Taris9047/astropix-telescope-ANL/README.md

# astropix-telescope

KiCad PCB project for a 4-Layer AstroPix Telescope compatible to AstroPix v2/v3
