Taris9047/astropix-telescope-ANL/Preliminary/AstroPix_telescope_Jan21th2023.png

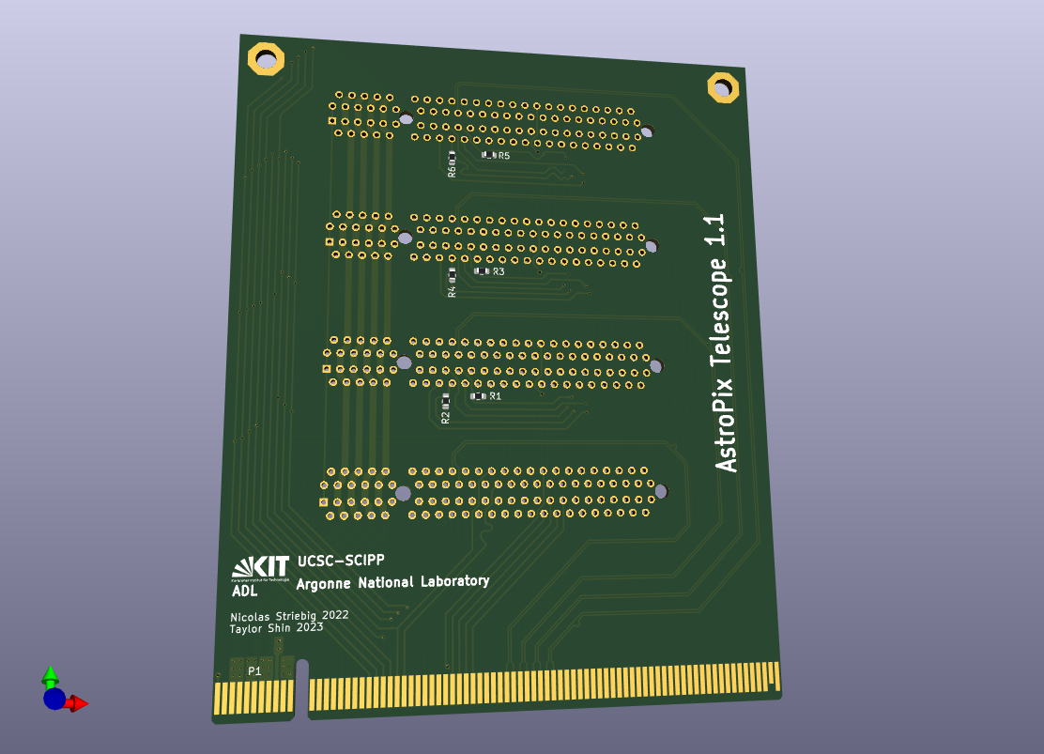
Preliminary/AstroPix_telescope_Jan21th2023.png
