Taris9047/astropix-telescope-ANL/References/ImpedanceMatching.png

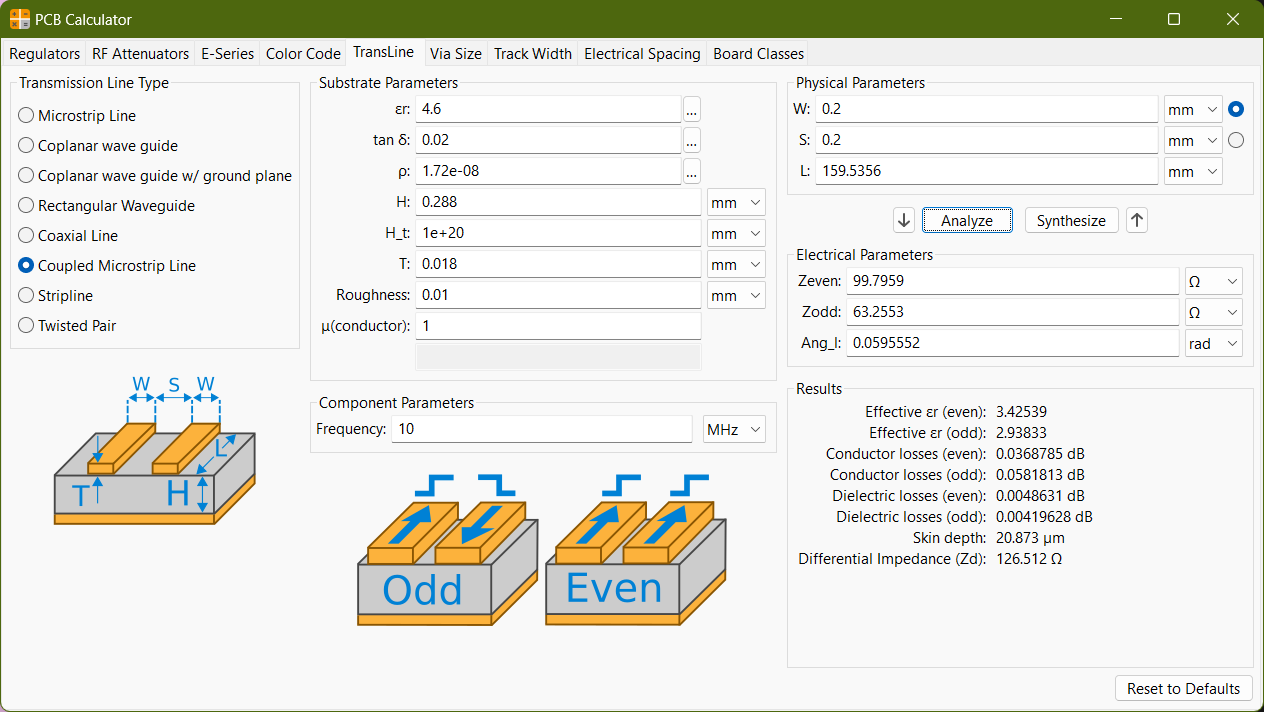
References/ImpedanceMatching.png
