Taris9047/astropix-telescope-ANL/FabricationOutputs/AstroPix_telescope.pdf

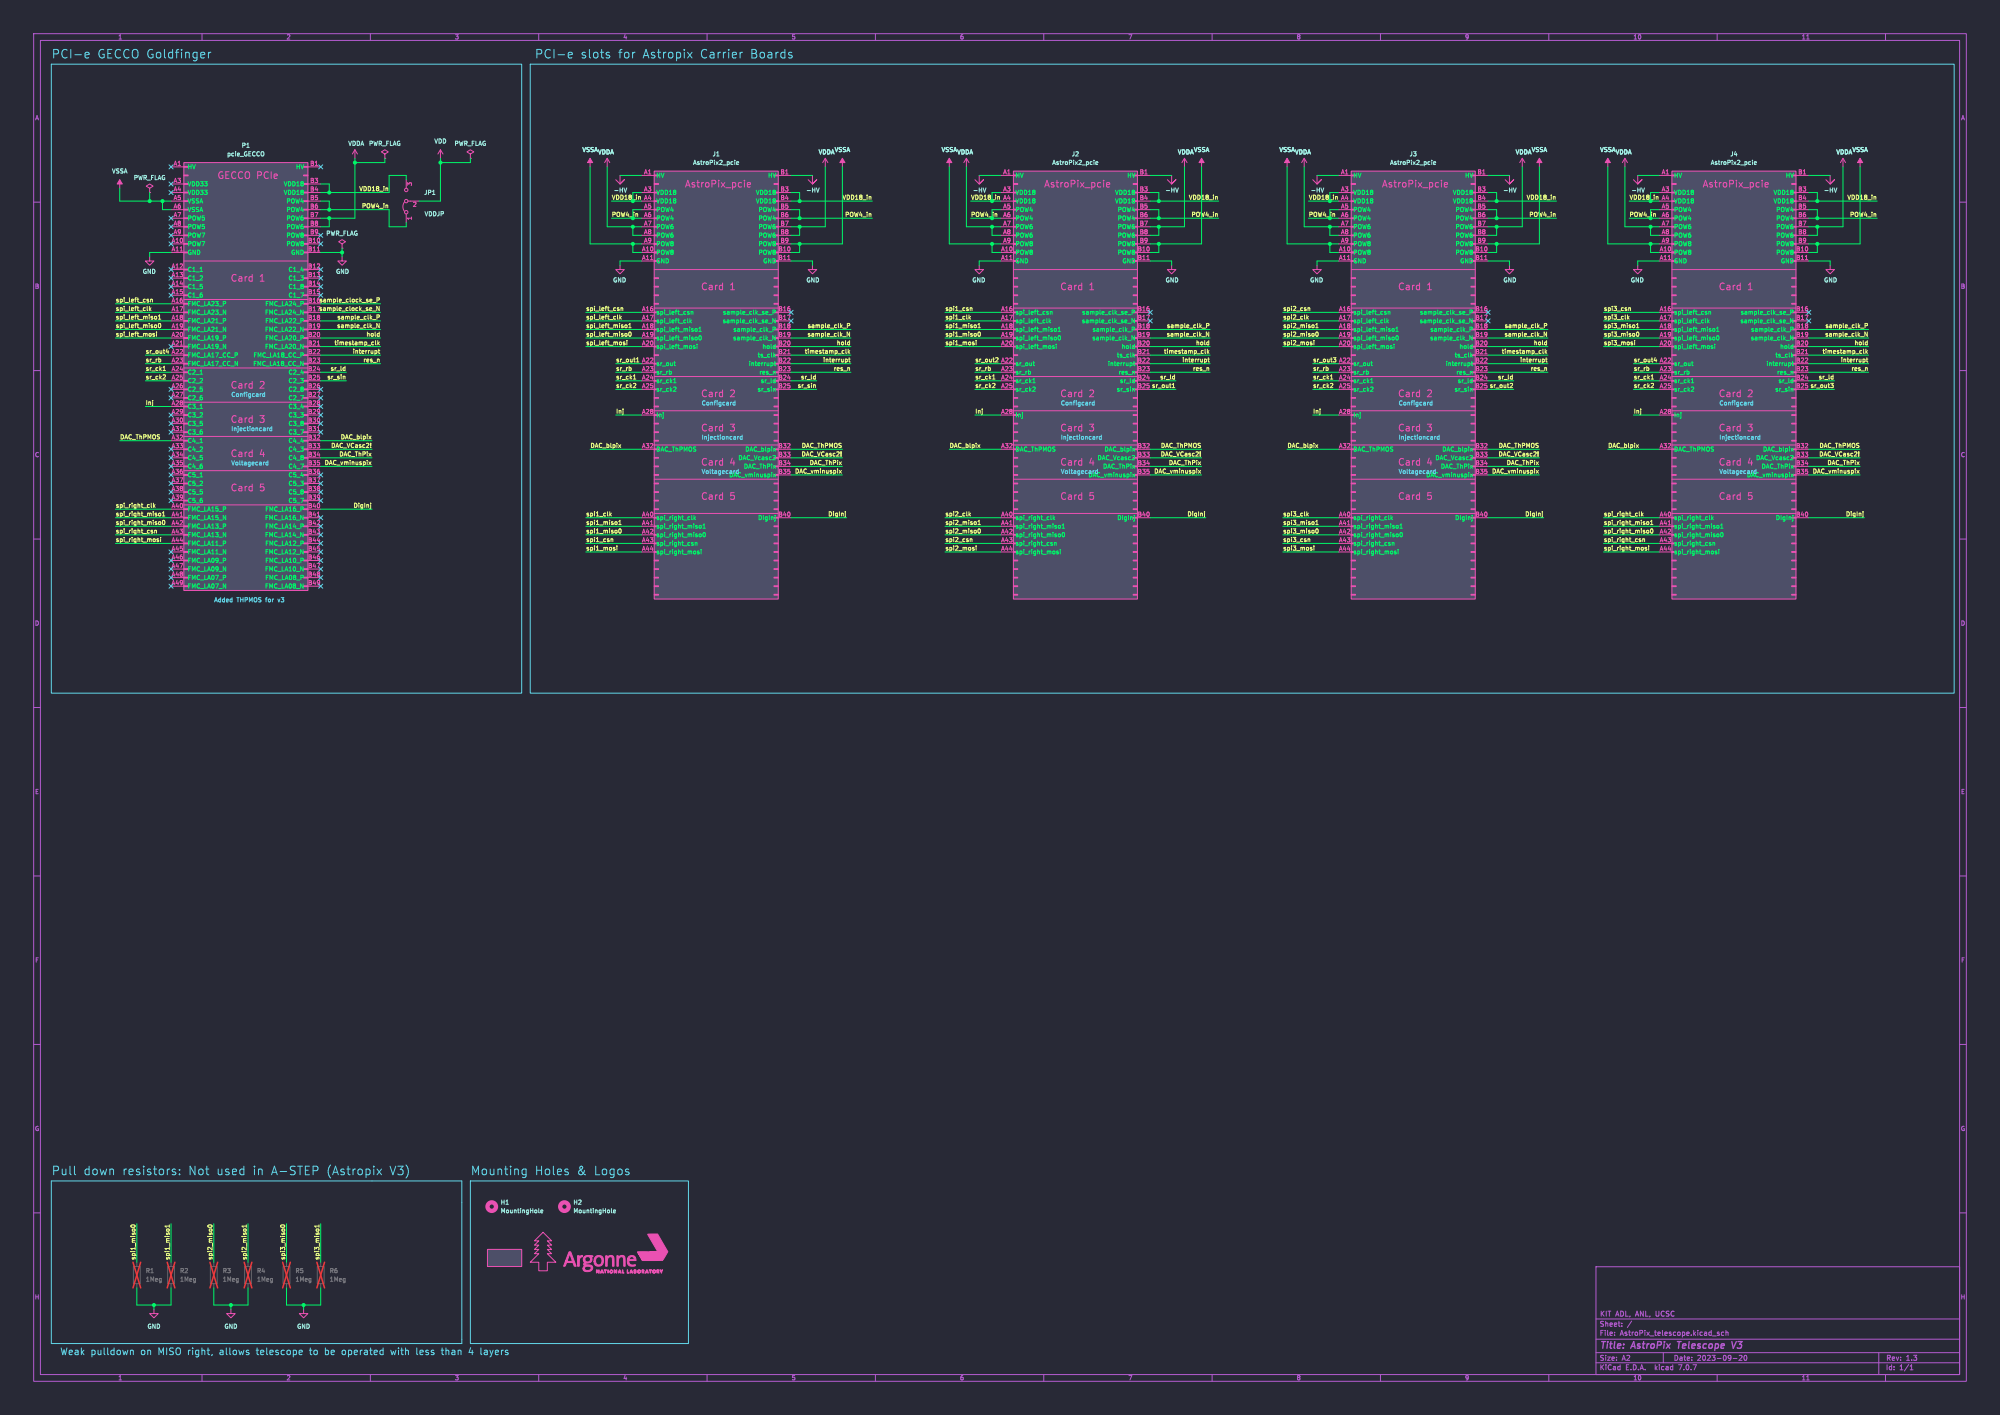
[picture p5: page 1]

PCI-e slots for Astropix Carrier Boards

File: AstroPix_telescope.kicad_sch Sheet: / KIT ADL, ANL, UCSC
