Taris9047/astropix-telescope-ANL/AstroPix_telescope.pdf

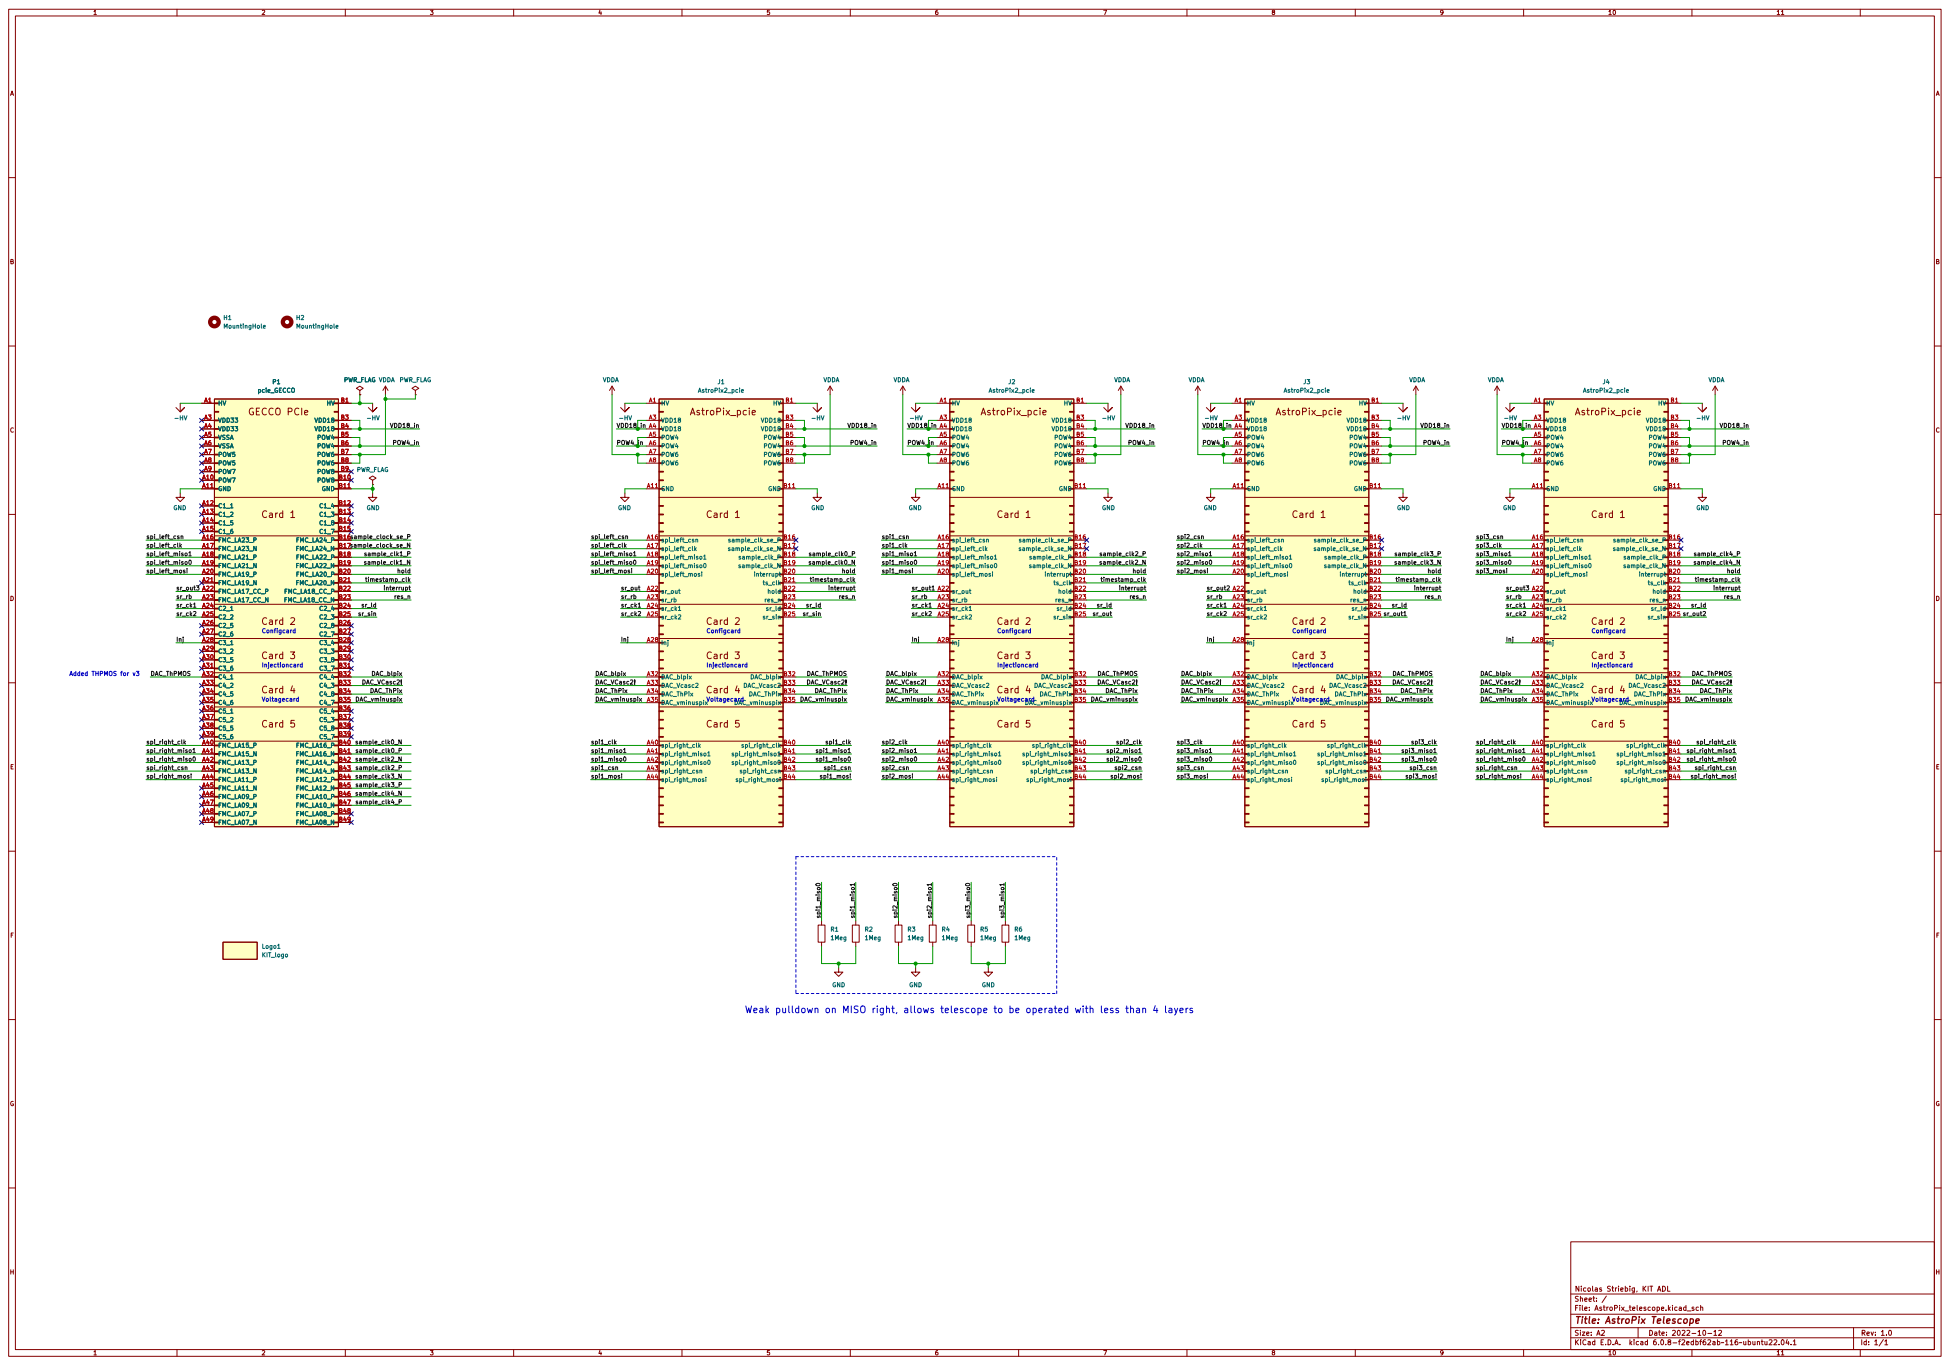
[picture p6: page 1]

Weak pulldown on MISO right, allows telescope to be operated with less than 4 layers

File: AstroPix_telescope.kicad_sch Sheet: / Nicolas Striebig, KIT ADL

Id: 1/1 Title: AstroPix Telescope
