Taris9047/astropix-telescope-ANL/AstroPix_telescope.kicad_pcb

## KiCad design AstroPix_telescope.kicad_pcb (2023-09-20)

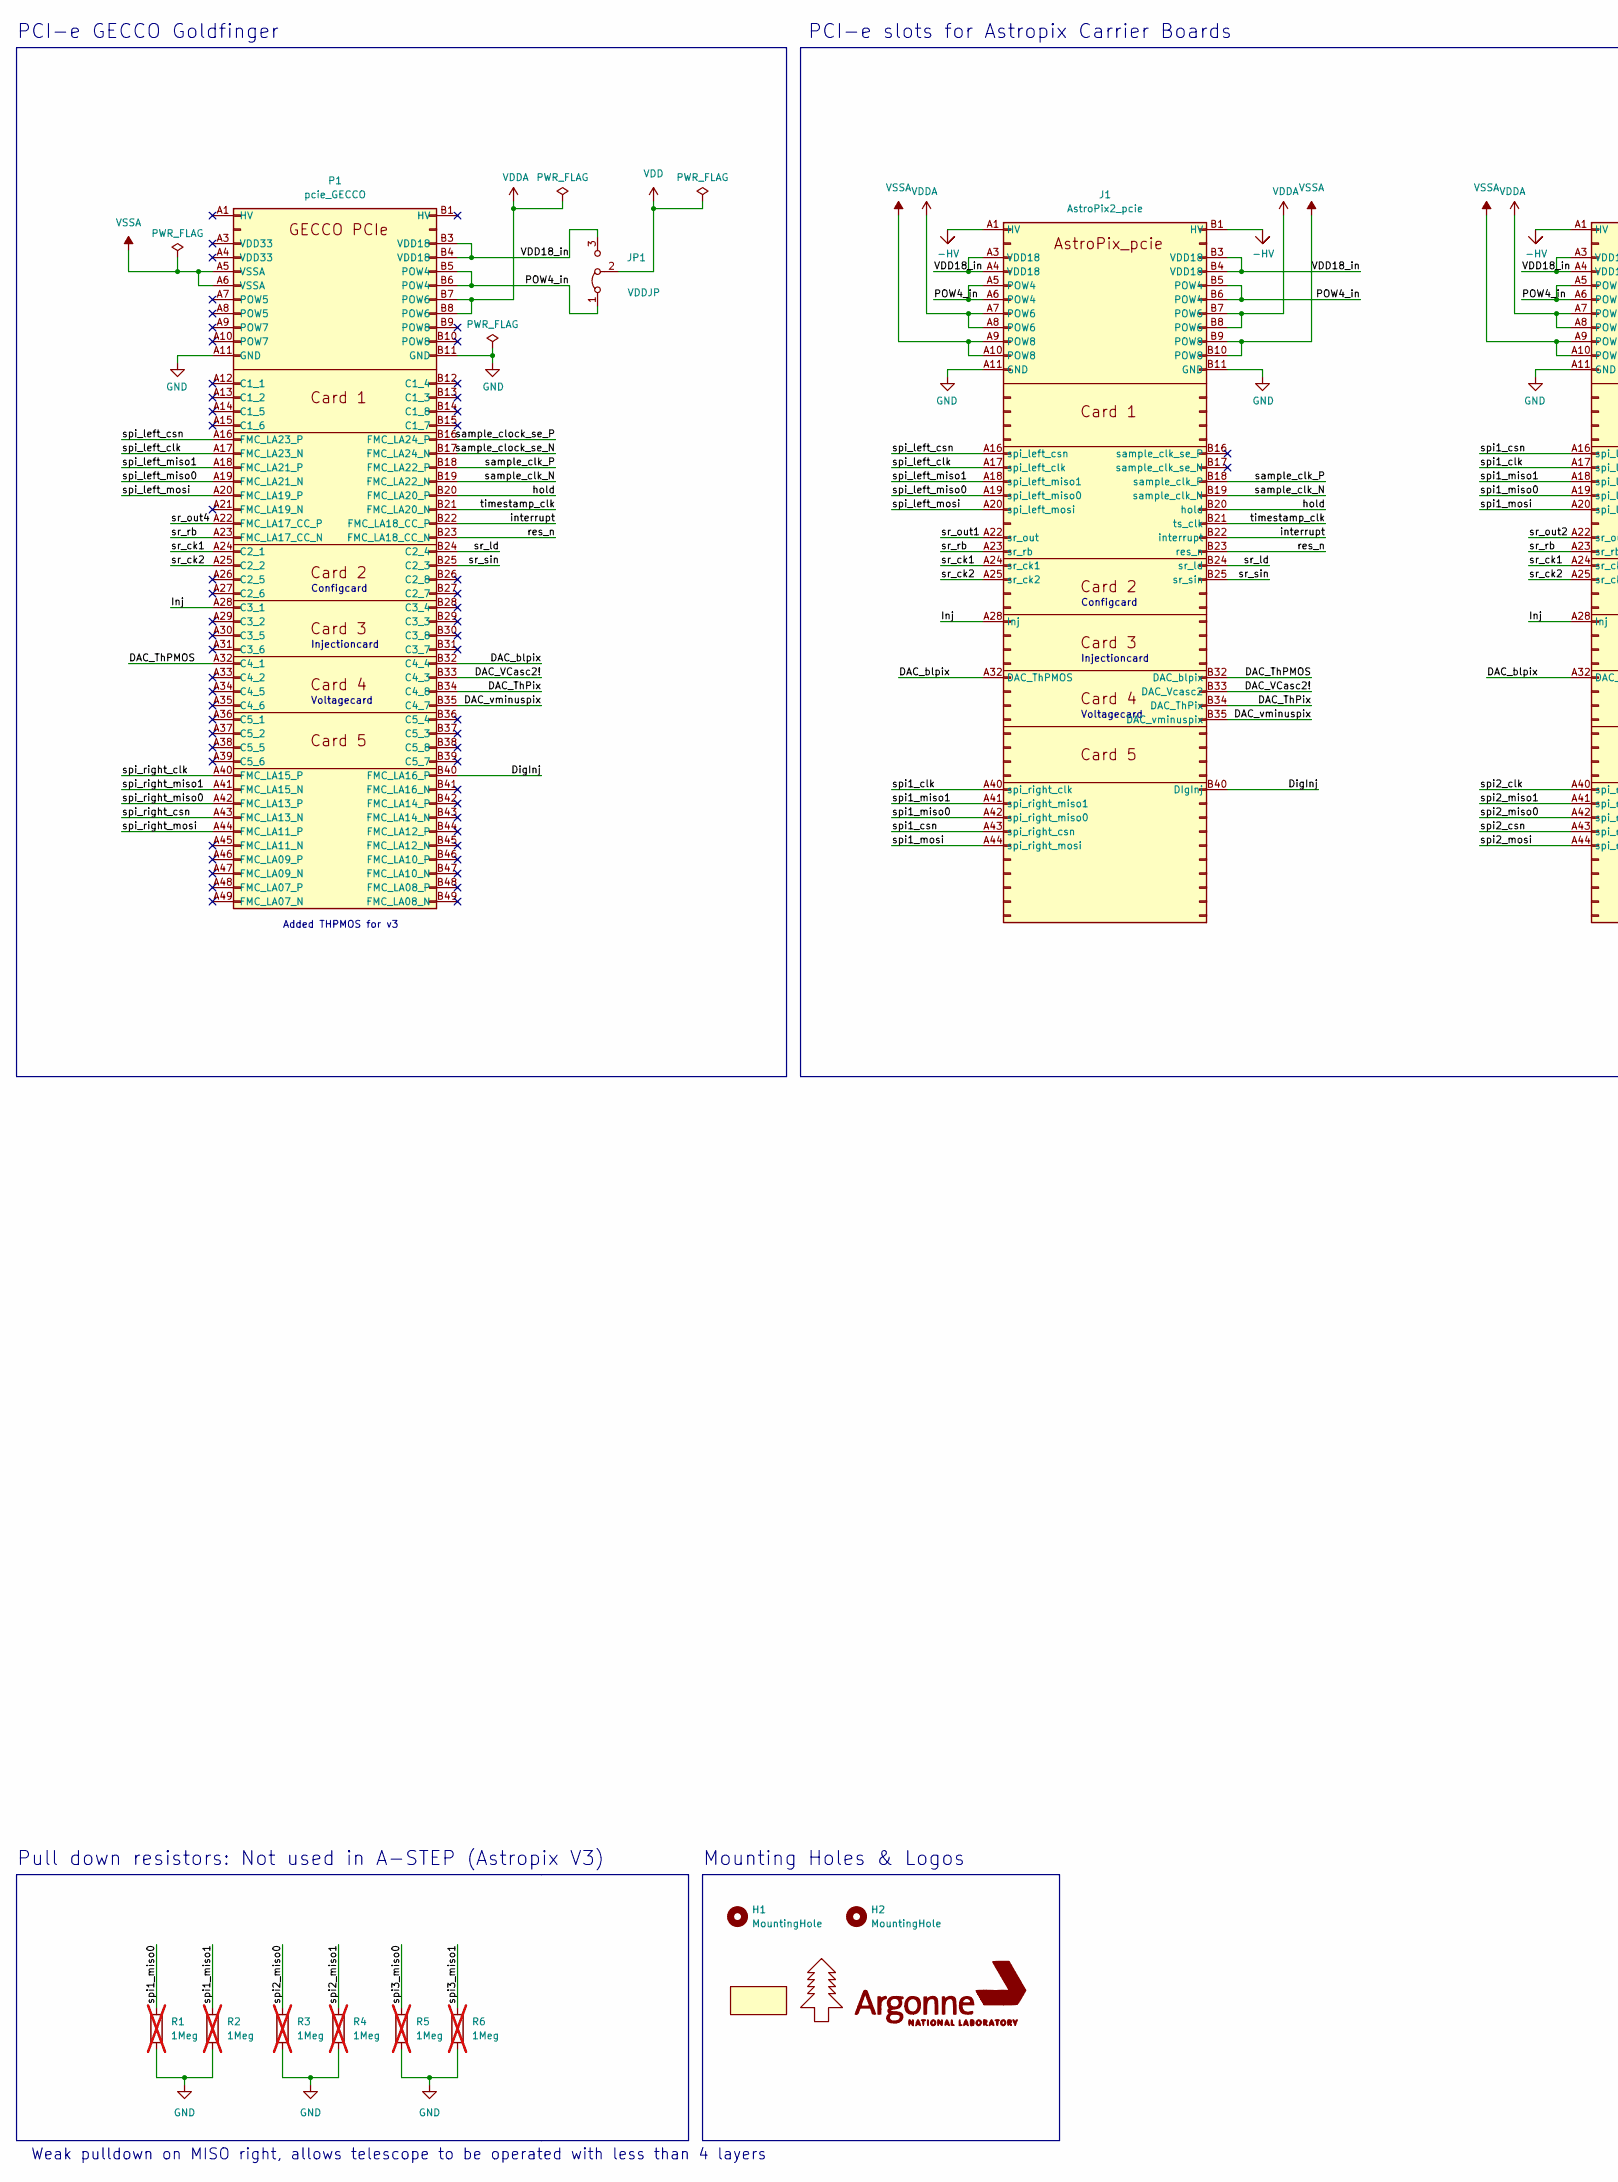
[picture p7: schematic AstroPix_telescope.kicad_sch, AstroPix Telescope V3, part in row 1, column 1]

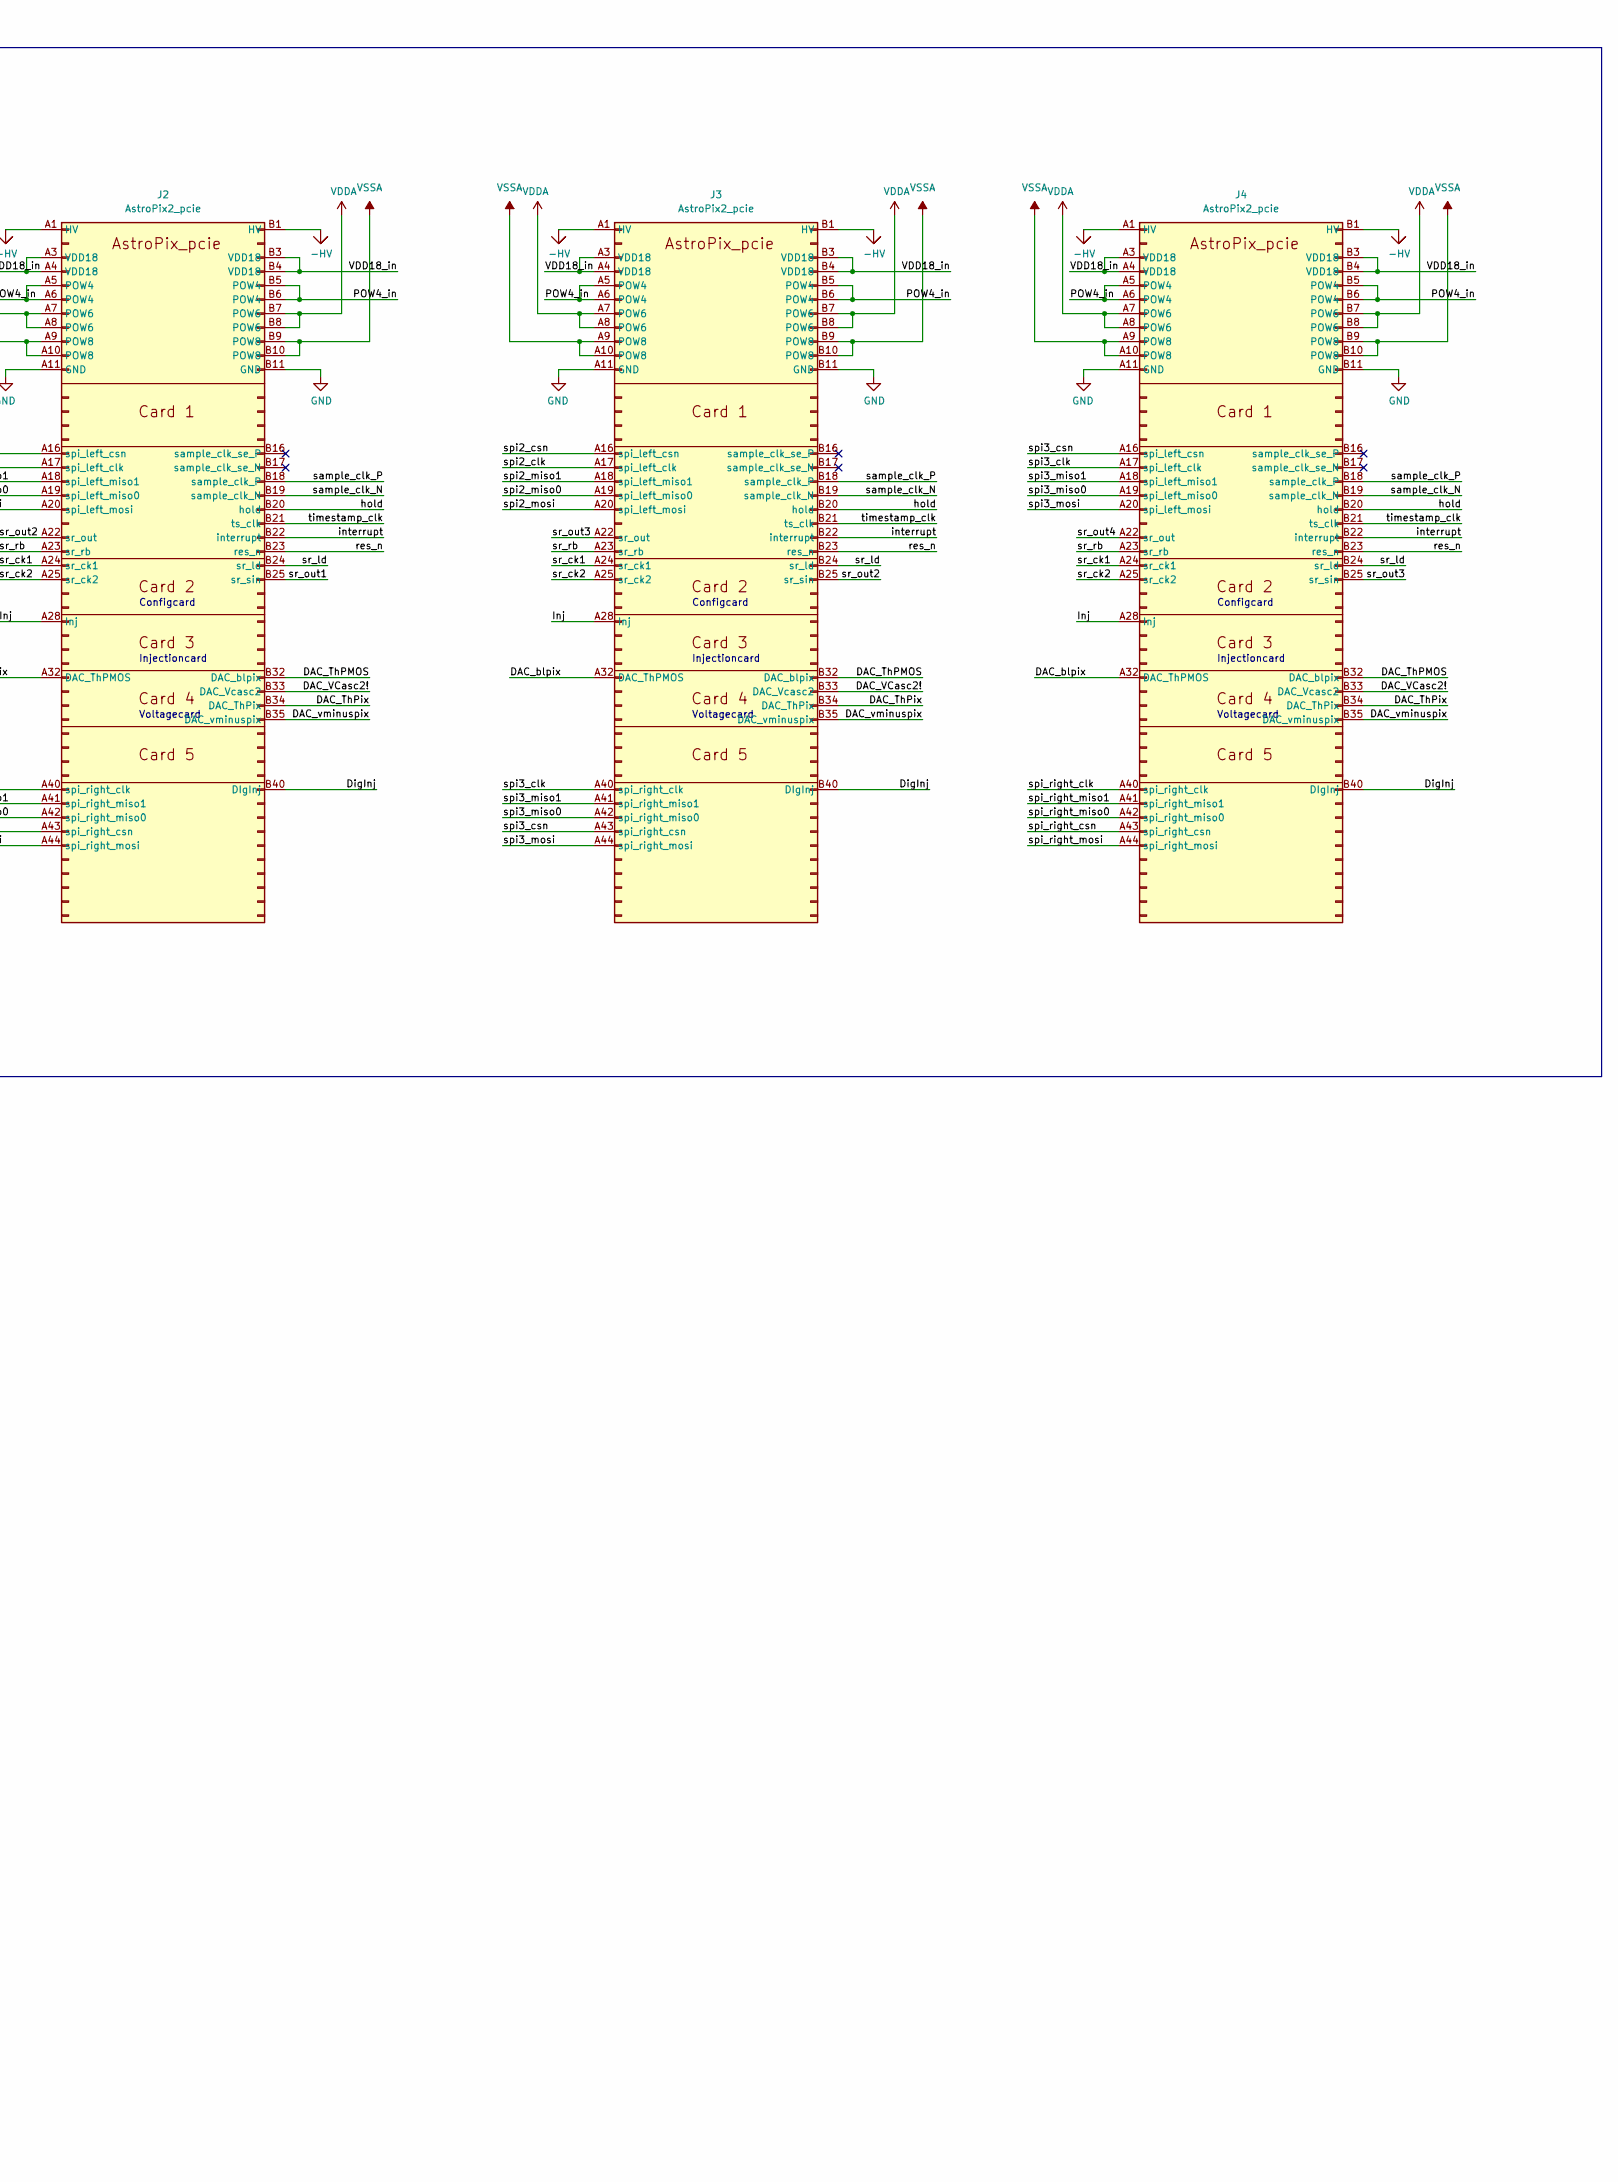
[picture p8: schematic AstroPix_telescope.kicad_sch, AstroPix Telescope V3, part in row 1, column 2]

Parts:
H1, H2: MountingHole; MountingHole_3.2mm_M3_DIN965_Pad
J1, J2, J3, J4: AstroPix2_pcie; SAMTEC_PCIE-098-02-X-D-TH
JP1: VDDJP; PinHeader_1x03_P2.54mm_Vertical
Logo1: KIT_logo; logo
Logo2: SCIPP_Logo
Logo3: ANL_LOGO; ANL_Logo
P1: pcie_GECCO; BUS_PCIexpress_x16_mod
R1, R2, R3, R4, R5, R6: 1Meg; R_0603_1608Metric; not fitted

Connections:
-HV: J1.A1 (HV), J1.B1 (HV), J2.A1 (HV), J2.B1 (HV), J3.A1 (HV), J3.B1 (HV), J4.A1 (HV), J4.B1 (HV)
/DAC_ThPMOS: J1.B32 (DAC_blpix), J2.B32 (DAC_blpix), J3.B32 (DAC_blpix), J4.B32 (DAC_blpix), P1.A32 (C4_1)
/DAC_ThPix: J1.B34 (DAC_ThPix), J2.B34 (DAC_ThPix), J3.B34 (DAC_ThPix), J4.B34 (DAC_ThPix), P1.B34 (C4_8)
/DAC_VCasc2!: J1.B33 (DAC_Vcasc2), J2.B33 (DAC_Vcasc2), J3.B33 (DAC_Vcasc2), J4.B33 (DAC_Vcasc2), P1.B33 (C4_3)
/DAC_blpix: J1.A32 (DAC_ThPMOS), J2.A32 (DAC_ThPMOS), J3.A32 (DAC_ThPMOS), J4.A32 (DAC_ThPMOS), P1.B32 (C4_4)
/DAC_vminuspix: J1.B35 (DAC_vminuspix), J2.B35 (DAC_vminuspix), J3.B35 (DAC_vminuspix), J4.B35 (DAC_vminuspix), P1.B35 (C4_7)
/DigInj: J1.B40 (DIgInj), J2.B40 (DIgInj), J3.B40 (DIgInj), J4.B40 (DIgInj), P1.B40 (FMC_LA16_P)
/Inj: J1.A28 (Inj), J2.A28 (Inj), J3.A28 (Inj), J4.A28 (Inj), P1.A28 (C3_1)
/POW4_in: J1.A5 (POW4), J1.A6 (POW4), J1.B5 (POW4), J1.B6 (POW4), J2.A5 (POW4), J2.A6 (POW4), J2.B5 (POW4), J2.B6 (POW4), J3.A5 (POW4), J3.A6 (POW4), J3.B5 (POW4), J3.B6 (POW4), J4.A5 (POW4), J4.A6 (POW4), J4.B5 (POW4), J4.B6 (POW4), JP1.1 (A), P1.B5 (POW4), P1.B6 (POW4)
/VDD18_in: J1.A3 (VDD18), J1.A4 (VDD18), J1.B3 (VDD18), J1.B4 (VDD18), J2.A3 (VDD18), J2.A4 (VDD18), J2.B3 (VDD18), J2.B4 (VDD18), J3.A3 (VDD18), J3.A4 (VDD18), J3.B3 (VDD18), J3.B4 (VDD18), J4.A3 (VDD18), J4.A4 (VDD18), J4.B3 (VDD18), J4.B4 (VDD18), JP1.3 (B), P1.B3 (VDD18), P1.B4 (VDD18)
/hold: J1.B20 (hold), J2.B20 (hold), J3.B20 (hold), J4.B20 (hold), P1.B20 (FMC_LA20_P)
/interrupt: J1.B22 (interrupt), J2.B22 (interrupt), J3.B22 (interrupt), J4.B22 (interrupt), P1.B22 (FMC_LA18_CC_P)
/res_n: J1.B23 (res_n), J2.B23 (res_n), J3.B23 (res_n), J4.B23 (res_n), P1.B23 (FMC_LA18_CC_N)
/sample_clk_N: J1.B19 (sample_clk_N), J2.B19 (sample_clk_N), J3.B19 (sample_clk_N), J4.B19 (sample_clk_N), P1.B19 (FMC_LA22_N)
/sample_clk_P: J1.B18 (sample_clk_P), J2.B18 (sample_clk_P), J3.B18 (sample_clk_P), J4.B18 (sample_clk_P), P1.B18 (FMC_LA22_P)
/sample_clock_se_N: P1.B17 (FMC_LA24_N)
/sample_clock_se_P: P1.B16 (FMC_LA24_P)
/spi1_clk: J1.A40 (spi_right_clk), J2.A17 (spi_left_clk)
/spi1_csn: J1.A43 (spi_right_csn), J2.A16 (spi_left_csn)
/spi1_miso0: J1.A42 (spi_right_miso0), J2.A19 (spi_left_miso0), R1.1
/spi1_miso1: J1.A41 (spi_right_miso1), J2.A18 (spi_left_miso1), R2.1
/spi1_mosi: J1.A44 (spi_right_mosi), J2.A20 (spi_left_mosi)
/spi2_clk: J2.A40 (spi_right_clk), J3.A17 (spi_left_clk)
/spi2_csn: J2.A43 (spi_right_csn), J3.A16 (spi_left_csn)
/spi2_miso0: J2.A42 (spi_right_miso0), J3.A19 (spi_left_miso0), R3.1
/spi2_miso1: J2.A41 (spi_right_miso1), J3.A18 (spi_left_miso1), R4.1
/spi2_mosi: J2.A44 (spi_right_mosi), J3.A20 (spi_left_mosi)
/spi3_clk: J3.A40 (spi_right_clk), J4.A17 (spi_left_clk)
/spi3_csn: J3.A43 (spi_right_csn), J4.A16 (spi_left_csn)
/spi3_miso0: J3.A42 (spi_right_miso0), J4.A19 (spi_left_miso0), R5.1
/spi3_miso1: J3.A41 (spi_right_miso1), J4.A18 (spi_left_miso1), R6.1
/spi3_mosi: J3.A44 (spi_right_mosi), J4.A20 (spi_left_mosi)
/spi_left_clk: J1.A17 (spi_left_clk), P1.A17 (FMC_LA23_N)
/spi_left_csn: J1.A16 (spi_left_csn), P1.A16 (FMC_LA23_P)
/spi_left_miso0: J1.A19 (spi_left_miso0), P1.A19 (FMC_LA21_N)
/spi_left_miso1: J1.A18 (spi_left_miso1), P1.A18 (FMC_LA21_P)
/spi_left_mosi: J1.A20 (spi_left_mosi), P1.A20 (FMC_LA19_P)
/spi_right_clk: J4.A40 (spi_right_clk), P1.A40 (FMC_LA15_P)
/spi_right_csn: J4.A43 (spi_right_csn), P1.A43 (FMC_LA13_N)
/spi_right_miso0: J4.A42 (spi_right_miso0), P1.A42 (FMC_LA13_P)
/spi_right_miso1: J4.A41 (spi_right_miso1), P1.A41 (FMC_LA15_N)
/spi_right_mosi: J4.A44 (spi_right_mosi), P1.A44 (FMC_LA11_P)
/sr_ck1: J1.A24 (sr_ck1), J2.A24 (sr_ck1), J3.A24 (sr_ck1), J4.A24 (sr_ck1), P1.A24 (C2_1)
/sr_ck2: J1.A25 (sr_ck2), J2.A25 (sr_ck2), J3.A25 (sr_ck2), J4.A25 (sr_ck2), P1.A25 (C2_2)
/sr_ld: J1.B24 (sr_ld), J2.B24 (sr_ld), J3.B24 (sr_ld), J4.B24 (sr_ld), P1.B24 (C2_4)
/sr_out1: J1.A22 (sr_out), J2.B25 (sr_sin)
/sr_out2: J2.A22 (sr_out), J3.B25 (sr_sin)
/sr_out3: J3.A22 (sr_out), J4.B25 (sr_sin)
/sr_out4: J4.A22 (sr_out), P1.A22 (FMC_LA17_CC_P)
/sr_rb: J1.A23 (sr_rb), J2.A23 (sr_rb), J3.A23 (sr_rb), J4.A23 (sr_rb), P1.A23 (FMC_LA17_CC_N)
/sr_sin: J1.B25 (sr_sin), P1.B25 (C2_3)
/timestamp_clk: J1.B21 (ts_clk), J2.B21 (ts_clk), J3.B21 (ts_clk), J4.B21 (ts_clk), P1.B21 (FMC_LA20_N)

Notes on the sheet:
Pull down resistors: Not used in A-STEP (Astropix V3)
Weak pulldown on MISO right, allows telescope to be operated with less than 4 layers
Configcard
Voltagecard
Mounting Holes & Logos
Injectioncard
Added THPMOS for v3
PCI-e GECCO Goldfinger
PCI-e slots for Astropix Carrier Boards

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
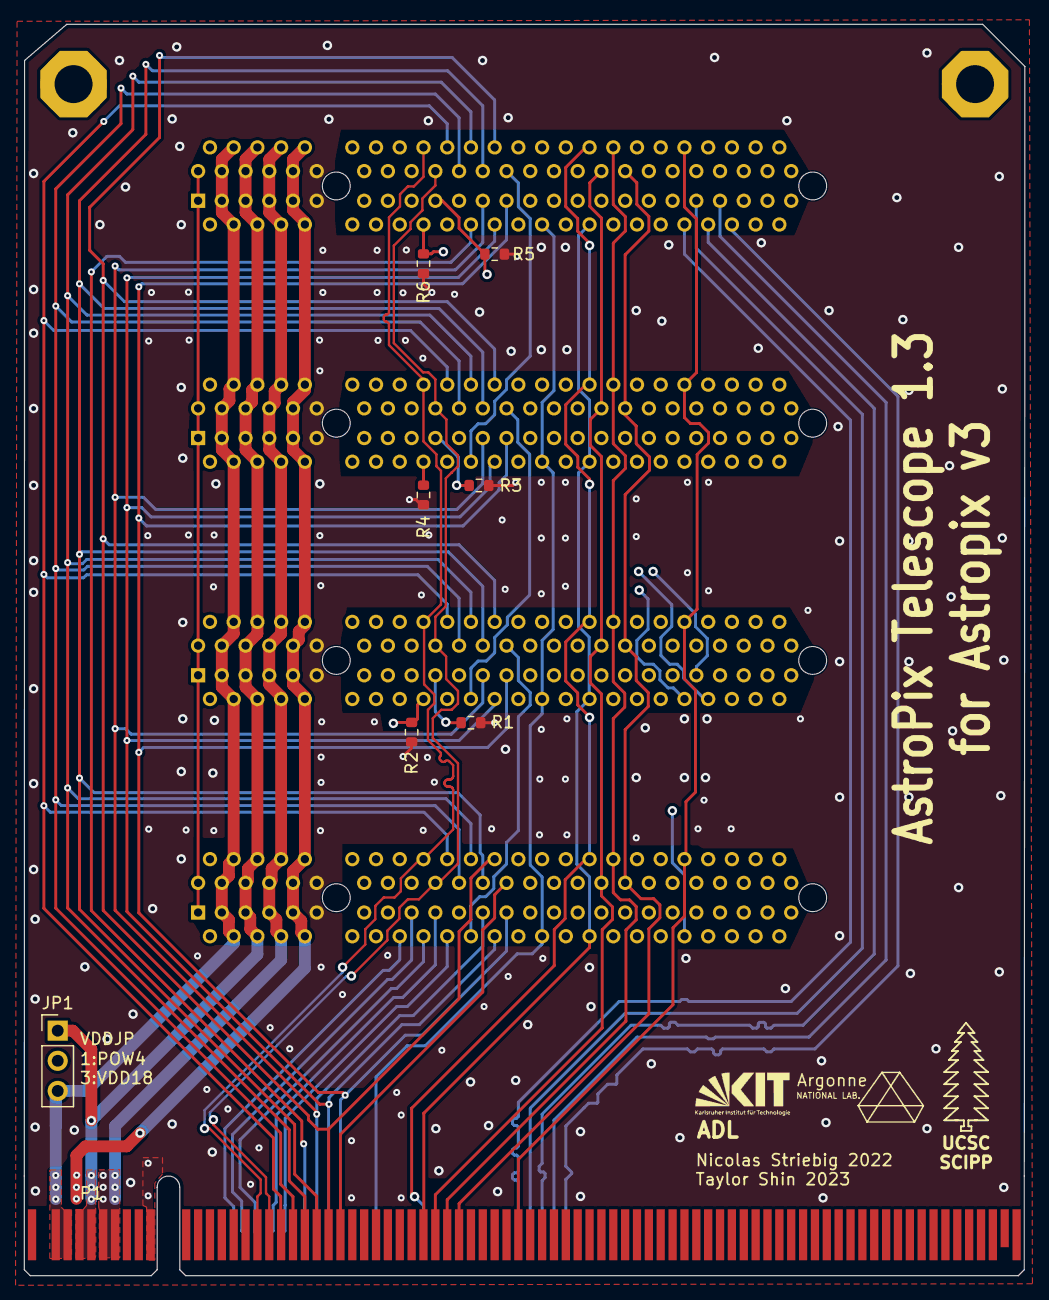
[picture p9: board AstroPix_telescope.kicad_pcb from above]

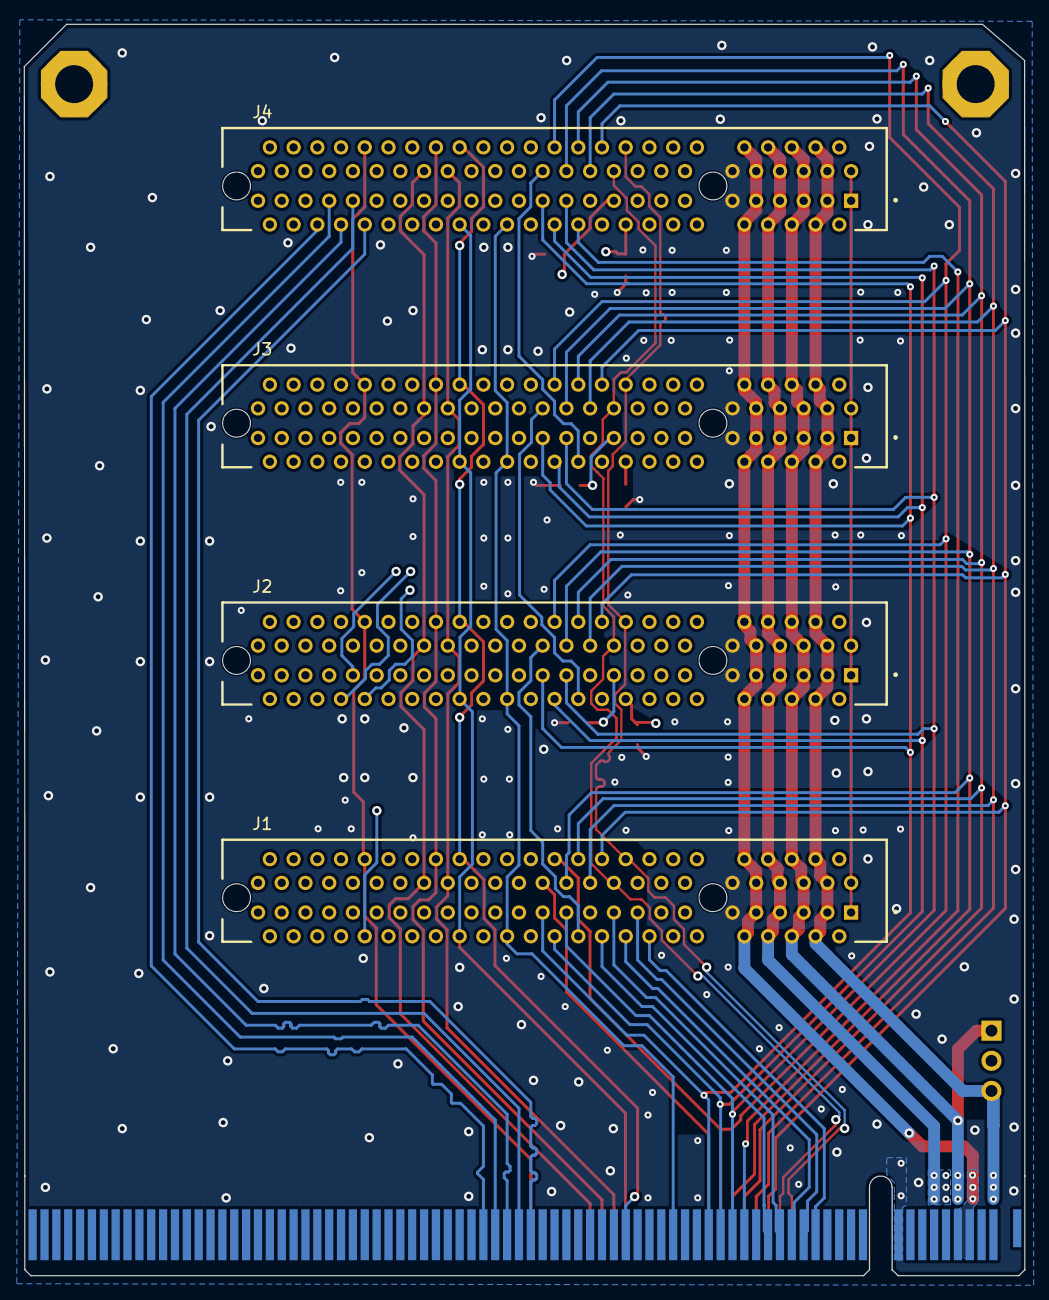
[picture p10: board AstroPix_telescope.kicad_pcb from below]

Board: 4 copper layers, 84.4 x 105.5 mm, 17 parts (4 on the bottom side), 53 nets.
