Taris9047/astropix-telescope-ANL/(commit log)

2022-10-12 Added custom pcie x16 footprint
2022-10-12 Added Logo + minor improvements
    [AstroPix_telescope.kicad_pcb, AstroPix_telescope.kicad_sch]
2022-10-12 Added schematic pdf
2022-10-12 Layout minor improvements
    [AstroPix_telescope.kicad_pcb]
2022-10-14 Added signal thPMOS, viastitching and removed unused rings
    [AstroPix_telescope.kicad_pcb, AstroPix_telescope.kicad_sch]
2022-10-14 Updated schematic pdf
2022-11-14 Added VSSA for Astropix3
    [AstroPix_telescope.kicad_pcb, AstroPix_telescope.kicad_sch]
2023-01-20 Applied most of corrections.
    And re-verified the 100 Ohm characteristic impedance.
    [AstroPix_telescope-B_Cu.gbr, AstroPix_telescope-B_Fab.gbr, AstroPix_telescope-B_Mask.gbr, AstroPix_telescope-B_Paste.gbr, AstroPix_telescope-B_Silkscreen.gbr, AstroPix_telescope-Edge_Cuts.gbr, AstroPix_telescope-F_Cu.gbr, AstroPix_telescope-F_Fab.gbr]
2023-01-20 Resolved spaghetti madness and matched line length as much as possible.
    Fabrication outputs prepared, yet again.
    [AstroPix_telescope-B_Cu.gbr, AstroPix_telescope-B_Fab.gbr, AstroPix_telescope-B_Mask.gbr, AstroPix_telescope-B_Paste.gbr, AstroPix_telescope-B_Silkscreen.gbr, AstroPix_telescope-Edge_Cuts.gbr, AstroPix_telescope-F_Cu.gbr, AstroPix_telescope-F_Fab.gbr]
2023-01-25 Updated with normalized differential pair length for each PCI-e ports.
    [AstroPix_telescope-B_Cu.gbr, AstroPix_telescope-B_Fab.gbr, AstroPix_telescope-B_Mask.gbr, AstroPix_telescope-B_Paste.gbr, AstroPix_telescope-B_Silkscreen.gbr, AstroPix_telescope-Edge_Cuts.gbr, AstroPix_telescope-F_Cu.gbr, AstroPix_telescope-F_Fab.gbr]
2023-01-25 1. Removed some acute corners at the differential pair lines of the first PCI-e connector. 2. Added Preliminary 3D shot. 3. Updated Fabrication Outputs.
    [AstroPix_telescope-B_Cu.gbr, AstroPix_telescope-B_Fab.gbr, AstroPix_telescope-B_Mask.gbr, AstroPix_telescope-B_Paste.gbr, AstroPix_telescope-B_Silkscreen.gbr, AstroPix_telescope-Edge_Cuts.gbr, AstroPix_telescope-F_Cu.gbr, AstroPix_telescope-F_Fab.gbr]
2023-01-26 Trigger board merged and prepared another fabrication output.
    [AstroPix_telescope-B_Cu.gbr, AstroPix_telescope-B_Fab.gbr, AstroPix_telescope-B_Mask.gbr, AstroPix_telescope-B_Paste.gbr, AstroPix_telescope-B_Silkscreen.gbr, AstroPix_telescope-Edge_Cuts.gbr, AstroPix_telescope-F_Cu.gbr, AstroPix_telescope-F_Fab.gbr]
2023-03-02 Migrated to KiCAD 7
    [AstroPix_telescope.kicad_sch]
2023-09-16 New Branch Added..
    [AstroPix_telescope.kicad_pcb]
2023-09-16 New revision.
    [AstroPix_telescope-B_Cu.gbr, AstroPix_telescope-B_Fab.gbr, AstroPix_telescope-B_Mask.gbr, AstroPix_telescope-B_Paste.gbr, AstroPix_telescope-B_Silkscreen.gbr, AstroPix_telescope-Edge_Cuts.gbr, AstroPix_telescope-F_Cu.gbr, AstroPix_telescope-F_Fab.gbr]
2023-09-19 Preliminary design...
    [AstroPix_telescope-B_Cu.gbr, AstroPix_telescope-B_Fab.gbr, AstroPix_telescope-B_Mask.gbr, AstroPix_telescope-B_Paste.gbr, AstroPix_telescope-B_Silkscreen.gbr, AstroPix_telescope-Edge_Cuts.gbr, AstroPix_telescope-F_Cu.gbr, AstroPix_telescope-F_Fab.gbr]
2023-09-20 V3 initial commit for fabrication.
    [AstroPix_telescope-B_Cu.gbr, AstroPix_telescope-B_Fab.gbr, AstroPix_telescope-B_Mask.gbr, AstroPix_telescope-B_Paste.gbr, AstroPix_telescope-B_Silkscreen.gbr, AstroPix_telescope-Edge_Cuts.gbr, AstroPix_telescope-F_Cu.gbr, AstroPix_telescope-F_Fab.gbr]
